Tommytom123/TELEMETRY_ISH_Greenpower/PCB SMD Design/SMD Microcontroller Schematics.kicad_pcb

## KiCad design PCB SMD Design/SMD Microcontroller Schematics.kicad_pcb (2024-05-22)

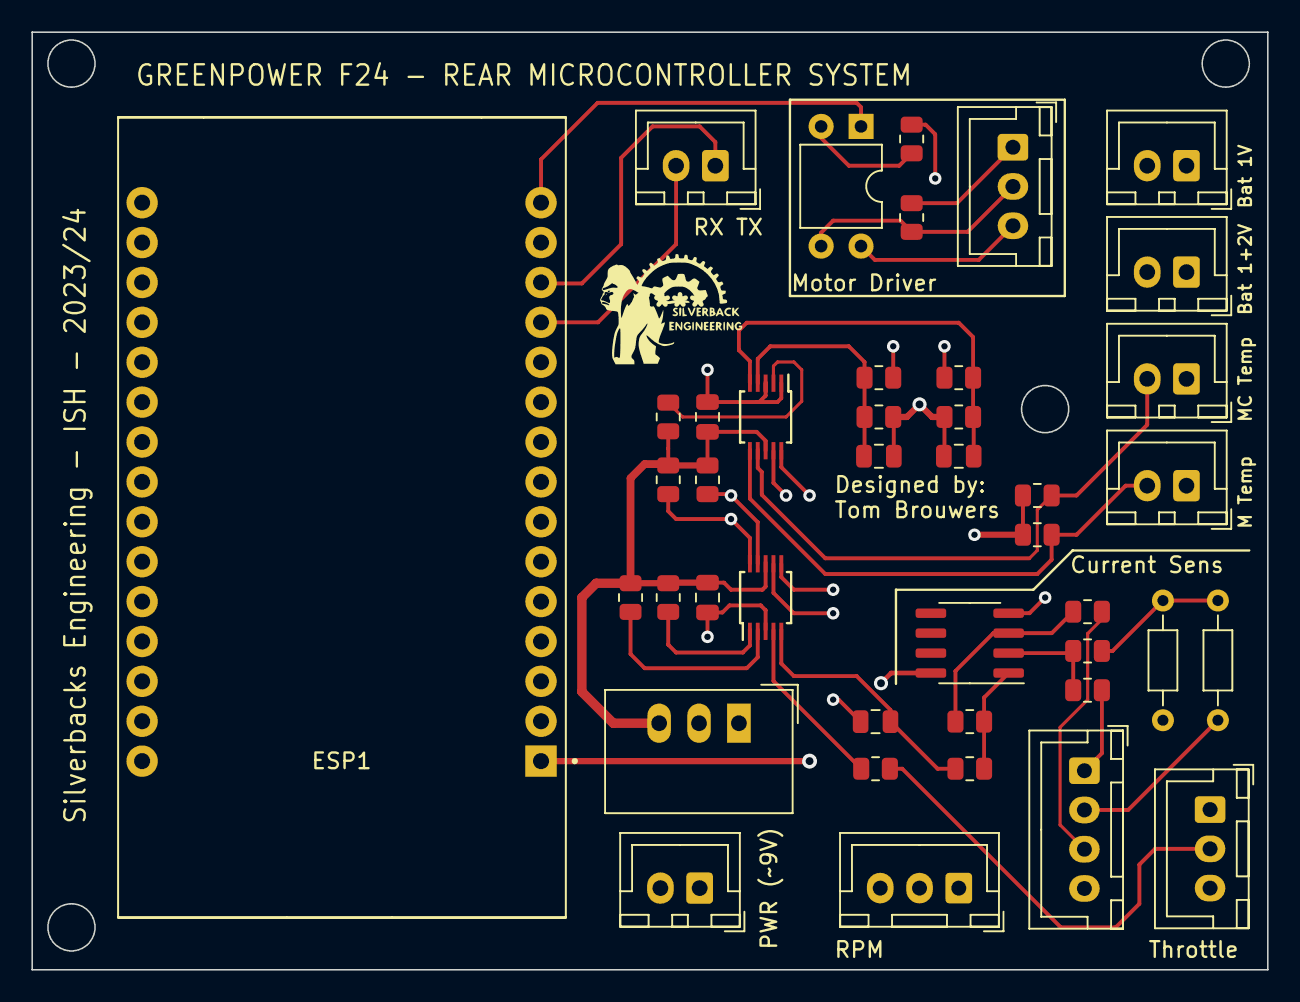
[picture p1: board SMD Microcontroller Schematics.kicad_pcb from above]

Board: 4 copper layers, 78.7 x 59.7 mm, 42 parts (0 on the bottom side), 32 nets.

Parts:
C1, C2: C; C_0805_2012Metric
C3: 1u; C_0805_2012Metric
C4, C5: 100nF; C_0805_2012Metric
ESP1: ESP32-DEVKIT-V1; MODULE_ESP32_DEVKIT_V1
J1: Power (9v); JST_XH_B2B-XH-A_1x02_P2.50mm_Vertical
J2: Data (RX TX); JST_XH_B2B-XH-A_1x02_P2.50mm_Vertical
J3: RPM Sensor; JST_XH_B3B-XH-A_1x03_P2.50mm_Vertical
J4: Bat 1V; JST_XH_B2B-XH-A_1x02_P2.50mm_Vertical
J5: Bat 1+2 V; JST_XH_B2B-XH-A_1x02_P2.50mm_Vertical
J6: Motor Temp; JST_XH_B2B-XH-A_1x02_P2.50mm_Vertical
J7: Motor Controller Temp; JST_XH_B2B-XH-A_1x02_P2.50mm_Vertical
J8: Current Sensor; JST_XH_B4B-XH-A_1x04_P2.50mm_Vertical
J9: Motor Controller; JST_XH_B3B-XH-A_1x03_P2.50mm_Vertical
J10: Throttle HallEffect; JST_XH_B3B-XH-A_1x03_P2.50mm_Vertical
R1, R2, R3, R4, R5, R6: R; R_0805_2012Metric
R7, R8: 4.7k; R_0805_2012Metric
R9, R10, R15, R16, R17, R18, R19: 10k; R_0805_2012Metric
R11: 47k; R_0805_2012Metric
R12, R14: 1k; R_0805_2012Metric
R13: 220; R_0805_2012Metric
R20, R21: ?; R_Axial_DIN0204_L3.6mm_D1.6mm_P7.62mm_Horizontal
U1: TSR_1-2450; Converter_DCDC_TRACO_TSR-1_THT
U2: MCP6002DRG; SOIC-8_3.9x4.9mm_P1.27mm
U3: PC817; DIP-4_W7.62mm
U4, U5: ADS1115IDGS; TSSOP-10_3x3mm_P0.5mm

Connections:
3.3V: ESP1.1 (3V3), J3.3, R5.1, R6.1
5V: C4.1, C5.1, J8.4, J10.3, R15.1, R16.1, R17.1, R18.1, R19.1, U1.3 (Vout), U2.8 (V+), U4.8 (VDD), U5.8 (VDD)
9V: ESP1.30 (VIN), J1.2, U1.1 (Vin)
/Data: J9.2, R12.1, U3.3
/Motor5V: J9.3, U3.4
/MotorGND: J9.1, R12.2
Current: C3.1, R11.1, U5.5 (AIN1)
GND: C1.2, C2.2, C3.2, C4.2, C5.2, ESP1.2 (GND), ESP1.29 (GND), J1.1, J3.1, J4.1, J5.1, J6.1, J7.1, J8.1, J10.1, R2.2, R4.2, R9.2, R13.1, R21.1, U1.2 (GND), U2.4 (V-), U4.1 (ADDR), U4.3 (GND), U5.3 (GND)
GP19: ESP1.10 (D19), J3.2
GPIO 27 - PWM: ESP1.15 (D23), U3.1
Motor Controller Temp: J7.2, R6.2, U4.7 (AIN3)
Motor Temp: J6.2, R5.2, U4.6 (AIN2)
unnamed: ESP1.12 (RX0), J2.2
unnamed: ESP1.13 (TX0), J2.1
unnamed: J4.2, R1.1
unnamed: J5.2, R3.1
unnamed: J8.2, R20.1
unnamed: J8.3, R7.2
unnamed: J10.2, R14.1
unnamed: R10.1, R11.2, U2.1
unnamed: R13.2, U3.2
unnamed: R8.2, R20.2, R21.2
unnamed: R7.1, R10.2, U2.3 (+)
unnamed: R8.1, R9.1, U2.2 (-)
unnamed: R16.2, U4.2 (ALERT/RDY)
unnamed: R17.2, U5.1 (ADDR)
unnamed: R14.2, U5.4 (AIN0)
unnamed: R15.2, U5.2 (ALERT/RDY)
Reduced Bat1V: C1.1, R1.2, R2.1, U4.4 (AIN0)
Reduced TotalV: C2.1, R3.2, R4.1, U4.5 (AIN1)
SCL: ESP1.14 (D22), R18.2, U4.10 (SCL), U5.10 (SCL)
SDA: ESP1.11 (D21), R19.2, U4.9 (SDA), U5.9 (SDA)
