Tommytom123/TELEMETRY_ISH_Greenpower/PCB Design/Microcontroller Schematics.kicad_pcb

## KiCad design PCB Design/Microcontroller Schematics.kicad_pcb (2023-12-18)

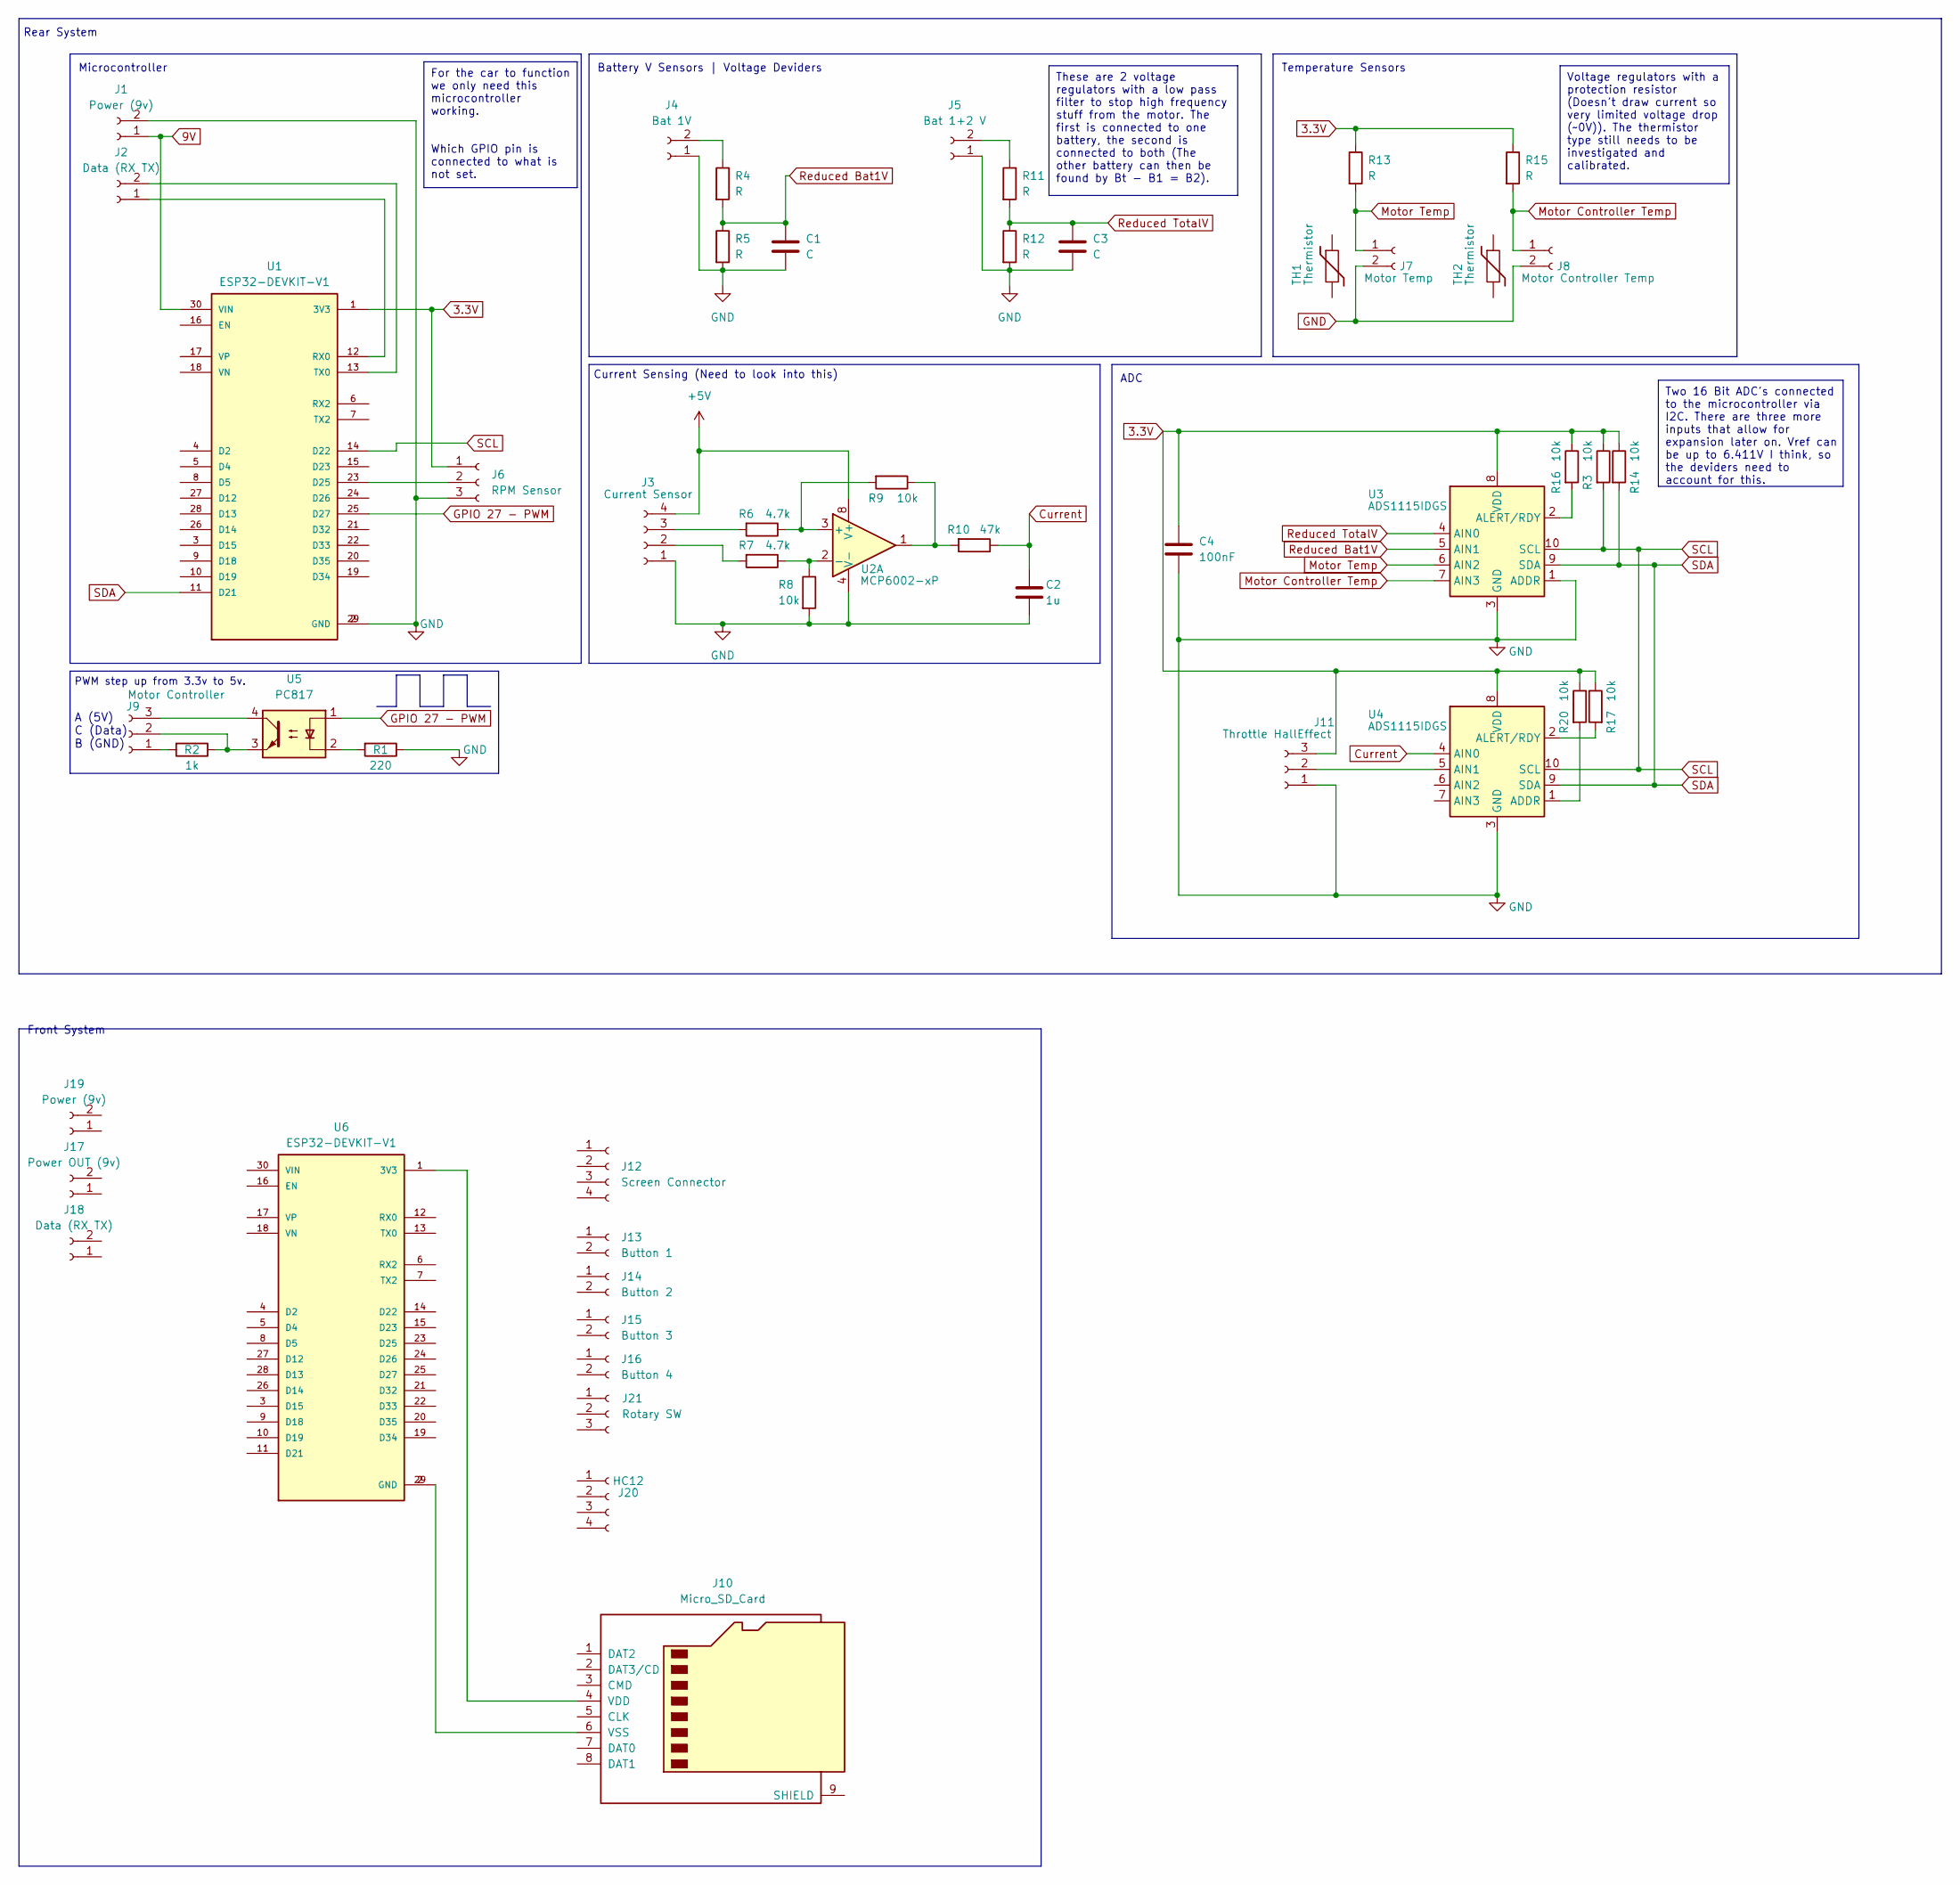
[picture p2: schematic Microcontroller Schematics.kicad_sch]

Parts:
C1, C3: C; C_Disc_D5.1mm_W3.2mm_P5.00mm
C2: 1u; C_Disc_D5.1mm_W3.2mm_P5.00mm
C4: 100nF; C_Disc_D5.1mm_W3.2mm_P5.00mm
J1, J19: Power (9v); JST_EH_S2B-EH_1x02_P2.50mm_Horizontal
J2, J18: Data (RX TX); JST_EH_S2B-EH_1x02_P2.50mm_Horizontal
J3: Current Sensor; JST_EH_S4B-EH_1x04_P2.50mm_Horizontal
J4: Bat 1V; JST_EH_S2B-EH_1x02_P2.50mm_Horizontal
J5: Bat 1+2 V; JST_EH_S2B-EH_1x02_P2.50mm_Horizontal
J6: RPM Sensor; JST_EH_S3B-EH_1x03_P2.50mm_Horizontal
J7: Motor Temp; JST_EH_S2B-EH_1x02_P2.50mm_Horizontal
J8: Motor Controller Temp; JST_EH_S2B-EH_1x02_P2.50mm_Horizontal
J9: Motor Controller; JST_EH_S3B-EH_1x03_P2.50mm_Horizontal
J10: Micro_SD_Card; microSD_HC_Hirose_DM3AT-SF-PEJM5
J11: Throttle HallEffect; JST_EH_S3B-EH_1x03_P2.50mm_Horizontal
J12: Screen Connector; JST_EH_S4B-EH_1x04_P2.50mm_Horizontal
J13: Button 1; JST_EH_S2B-EH_1x02_P2.50mm_Horizontal
J14: Button 2; JST_EH_S2B-EH_1x02_P2.50mm_Horizontal
J15: Button 3; JST_EH_S2B-EH_1x02_P2.50mm_Horizontal
J16: Button 4; JST_EH_S2B-EH_1x02_P2.50mm_Horizontal
J17: Power OUT (9v); JST_EH_S2B-EH_1x02_P2.50mm_Horizontal
J20: HC12; JST_EH_S4B-EH_1x04_P2.50mm_Horizontal
J21: Rotary SW; JST_EH_S3B-EH_1x03_P2.50mm_Horizontal
R1: 220; R_Axial_DIN0207_L6.3mm_D2.5mm_P10.16mm_Horizontal
R2: 1k; R_Axial_DIN0207_L6.3mm_D2.5mm_P10.16mm_Horizontal
R3, R8, R9, R14, R16, R17, R20: 10k; R_Axial_DIN0207_L6.3mm_D2.5mm_P10.16mm_Horizontal
R4, R5, R11, R12, R13, R15: R; R_Axial_DIN0207_L6.3mm_D2.5mm_P10.16mm_Horizontal
R6, R7: 4.7k; R_Axial_DIN0207_L6.3mm_D2.5mm_P10.16mm_Horizontal
R10: 47k; R_Axial_DIN0207_L6.3mm_D2.5mm_P10.16mm_Horizontal
TH1, TH2: Thermistor
U1, U6: ESP32-DEVKIT-V1; MODULE_ESP32_DEVKIT_V1; PARTREV N/A
U2: MCP6002-xP; DIP-8_W7.62mm_LongPads
U3, U4: ADS1115IDGS; TSSOP-10_3x3mm_P0.5mm
U5: PC817; DIP-4_W7.62mm

Connections:
3.3V: C4.1, J6.1, J11.3, R3.1, R13.1, R14.1, R15.1, R16.1, R17.1, R20.1, U1.1 (3V3), U3.8 (VDD), U4.8 (VDD)
9V: J1.1, U1.30 (VIN)
+5V: J3.4, U2.8 (V+)
Current: C2.1, R10.1, U4.4 (AIN0)
GND: C1.2, C2.2, C3.2, C4.2, J1.2, J3.1, J4.1, J5.1, J6.3, J7.2, J8.2, J11.1, R1.1, R5.2, R8.2, R12.2, U1.2 (GND), U1.29 (GND), U2.4 (V-), U3.1 (ADDR), U3.3 (GND), U4.3 (GND)
GPIO 27 - PWM: U1.25 (D27), U5.1
Motor Controller Temp: J8.1, R15.2, U3.7 (AIN3)
Motor Temp: J7.1, R13.2, U3.6 (AIN2)
unnamed: J2.1, U1.12 (RX0)
unnamed: J2.2, U1.13 (TX0)
unnamed: J3.2, R7.2
unnamed: J3.3, R6.2
unnamed: J4.2, R4.1
unnamed: J5.2, R11.1
unnamed: J6.2, U1.23 (D25)
unnamed: J9.1, R2.2
unnamed: J9.2, R2.1, U5.3
unnamed: J9.3, U5.4
unnamed: J10.4 (VDD), U6.1 (3V3)
unnamed: J10.6 (VSS), U6.2 (GND), U6.29 (GND)
unnamed: J11.2, U4.5 (AIN1)
unnamed: R1.2, U5.2
unnamed: R9.1, R10.2, U2.1
unnamed: R6.1, R9.2, U2.3 (+)
unnamed: R7.1, R8.1, U2.2 (-)
unnamed: R16.2, U3.2 (ALERT/RDY)
unnamed: R20.2, U4.1 (ADDR)
unnamed: R17.2, U4.2 (ALERT/RDY)
Reduced Bat1V: C1.1, R4.2, R5.1, U3.5 (AIN1)
Reduced TotalV: C3.1, R11.2, R12.1, U3.4 (AIN0)
SCL: R3.2, U1.14 (D22), U3.10 (SCL), U4.10 (SCL)
SDA: R14.2, U1.11 (D21), U3.9 (SDA), U4.9 (SDA)

Notes on the sheet:
For the car to function we only need this microcontroller working. Which GPIO pin is connected to what is not set.
Two 16 Bit ADC's connected to the microcontroller via I2C. There are three more inputs that allow for expansion later on. Vref can be up to 6.411V I think, so the deviders need to account for this.
These are 2 voltage regulators with a low pass filter to stop high frequency stuff from the motor. The first is connected to one battery, the second is connected to both (The other battery can then be found by Bt - B1 = B2).
Voltage regulators with a protection resistor (Doesn't draw current so very limited voltage drop (~0V)). The thermistor type still needs to be investigated and calibrated.
Rear System
ADC
Front System
A (5V) C (Data) B (GND)
PWM step up from 3.3v to 5v.
Temperature Sensors
Battery V Sensors | Voltage Deviders
Current Sensing (Need to look into this)
Microcontroller

Board: 2 copper layers, 49 parts (0 on the bottom side), 32 nets, no tracks yet.
