Tommytom123/TELEMETRY_ISH_Greenpower/MicroControllers/FRONT_MC/Bitmap.ino

// Code for the front Micro Controller. Written and compiled by Tom Brouwers. Elements by Elena and Alessandro.
// For use on the 2023/24 PCB boards.
// If you have any questions please email me at tommytom2006@icloud.com - or if ended up deprecating that one, please use tommaxbrouwers@gmail.com

// This document houses the bitmap for the startup screen.

/*
Arduino compiling works by first combining all the programs in the folder,
starting with the program with the same name then continues with  the rest in alphabetical order
It then compiles everything like one big file
*/  
const uint8_t bitMapH = 64;
const uint8_t bitMapW = 64;
static const unsigned char bitMapStartup[] U8X8_PROGMEM  = {
  0x00, 0x00, 0x00, 0x00, 0x00, 0x00, 0x00, 0x00, 0x00, 0x00, 0x00, 0x00, 0x00, 0x00, 0x00, 0x00, 0x00, 0x00, 0x00, 0x00, 0x00, 0x00, 0x00, 0x00, 0x00, 0x00, 0x00, 0x00, 0x00, 0x00, 0x00, 0x00, 0x00, 0x00, 0x00, 0x00, 0x00, 0x00, 0x00, 0x00, 0x00, 0x00, 0x00, 0x00, 0x00, 0x00, 0x00, 0x00, 0x00, 0x00, 0x00, 0x00, 0x00, 0x00, 0x00, 0x00, 0x00, 0x00, 0x00, 0x00, 0x00, 0x00, 0x00, 0x00, 
  0x00, 0x00, 0x00, 0x00, 0x00, 0x00, 0x00, 0x00, 0x00, 0x00, 0x00, 0x00, 0x00, 0x80, 0x80, 0x80, 0xc0, 0xc0, 0xc0, 0xc0, 0xe0, 0xe0, 0xe0, 0xe0, 0xf0, 0xe0, 0x00, 0x00, 0x00, 0x00, 0x00, 0x00, 0x00, 0x00, 0x00, 0x00, 0xc0, 0xe0, 0xf0, 0xf0, 0x60, 0x00, 0x00, 0x00, 0x00, 0x00, 0x00, 0x80, 0xc0, 0xe0, 0xf0, 0xf0, 0x60, 0x00, 0x00, 0x00, 0x00, 0x00, 0x00, 0x00, 0x00, 0x00, 0x00, 0x00, 
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
};
