Tommytom123/TELEMETRY_ISH_Greenpower/(commit log)

2023-10-08 Adding Motor Stuff
2023-10-10 Added throttle percentage
2023-10-16 Calibration
    Also accel has issues, so not sure if that should be recorded
2023-10-16 Cleaner and added pages for the buttons
2023-10-27 Added KiCAD SCHEMATICS!!!
    [ISH_TELEM_REAR.kicad_pcb, ISH_TELEM_REAR.kicad_sch]
2023-10-28 Added schematic for the front pcb thing
    [ISH_TELEM_FRONT.kicad_pcb, ISH_TELEM_FRONT.kicad_sch, ISH_TELEM_REAR.kicad_sch]
2023-10-29 Changed some stuff for the ADC
    [ISH_TELEM_REAR.kicad_sch]
2023-10-30 Started understanding the current sens stuff, and made a few adjustments
    [ISH_TELEM_REAR.kicad_sch]
2023-11-02 Make sure you don't push when a schematic is open
2023-11-09 Changed some V step up stuff
    [ISH_TELEM_REAR.kicad_sch]
2023-11-29 Moved to ESP32
2023-12-01 SD CARD WORKS
    SD.open (FILE_WRITE) is different for an arduino and ESP...
2023-12-02 MAJOR CHANGES - Improved collaborative Framework
2023-12-16 Worked on the PCB Design
    [ISH_TELEM_REAR.kicad_pcb]
2023-12-17 Remaking the PCB schematic for better clarity
    [ISH_TELEM_FRONT.kicad_pcb, ISH_TELEM_FRONT.kicad_sch, ISH_TELEM_REAR.kicad_pcb, ISH_TELEM_REAR.kicad_sch]
2023-12-17 Working on remaking the schematics
    [Microcontroller Schematics.kicad_pcb, Microcontroller Schematics.kicad_sch]
2023-12-18 Remade the through hole (TH) PCB
    [Microcontroller Schematics.kicad_pcb, Microcontroller Schematics.kicad_sch]
2023-12-20 PCB changes
    [SMD Microcontroller Schematics.kicad_pcb, SMD Microcontroller Schematics.kicad_sch]
2024-05-22 Many Changes
    [SMD Microcontroller Schematics-B_Cu.gbr, SMD Microcontroller Schematics-B_Mask.gbr, SMD Microcontroller Schematics-B_Paste.gbr, SMD Microcontroller Schematics-B_SilkS.gbr, SMD Microcontroller Schematics-B_Silkscreen.gbr, SMD Microcontroller Schematics-Edge_Cuts.gbr, SMD Microcontroller Schematics-F_Cu.gbr, SMD Microcontroller Schematics-F_Mask.gbr]
